DLABDE/-/src/RTOS电_mpu/readme.txt

工程文件说明：

freeRTOS，移植的实时操作系统

Libraries，移植的STM32F4官方库文件

Output，工程输出文件

Project，工程目录

User，用户代码
	eMPL，移植的MPU6050陀螺仪官方解算代码

keilkill.bat，windows脚本文件，自动清除工程编译产生的中间文件
