DLABDE/-/img/3-2.png

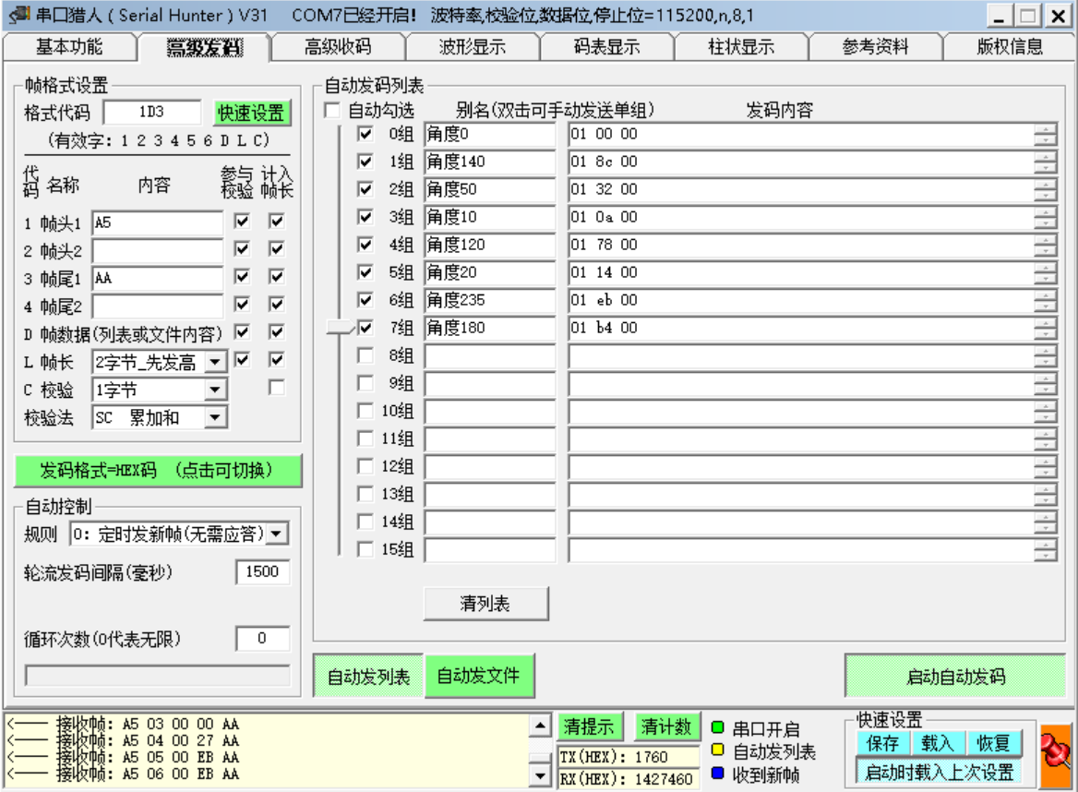
img/3-2.png
