DLABDE/-/img/3-4.png

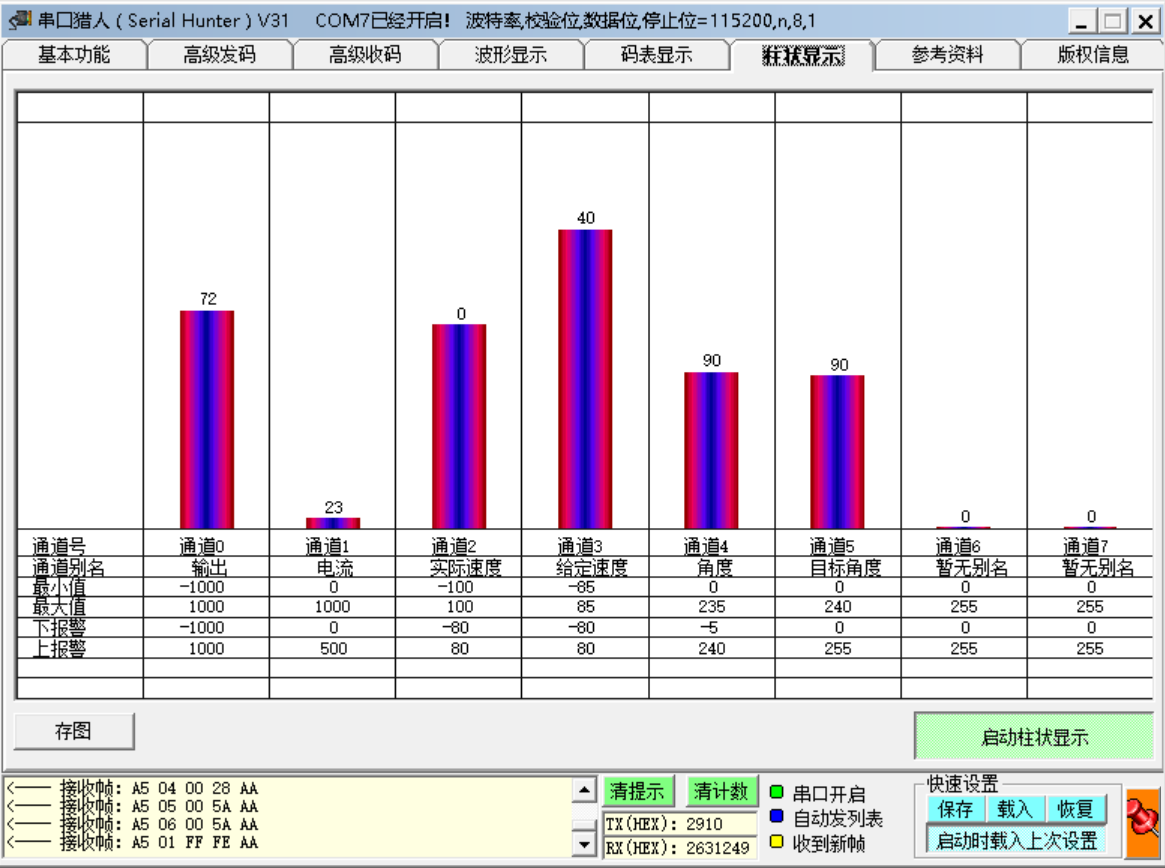
img/3-4.png
