DLABDE/-/img/xiaoming.jpg

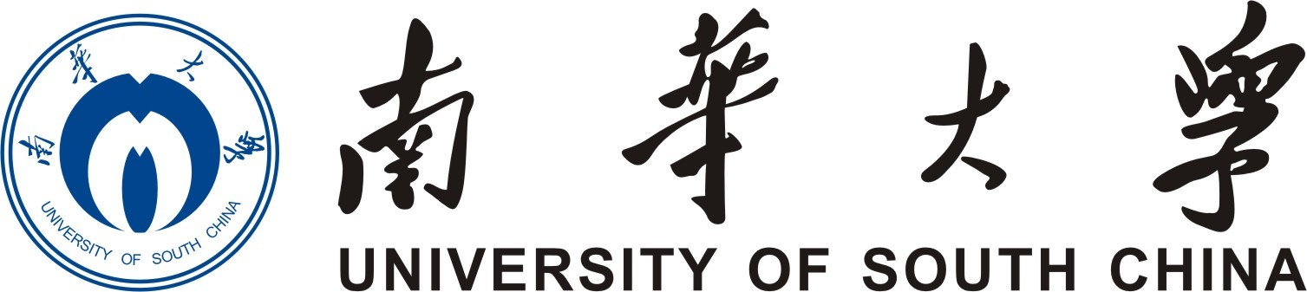
img/xiaoming.jpg
