DLABDE/-/img/控制板.jpg

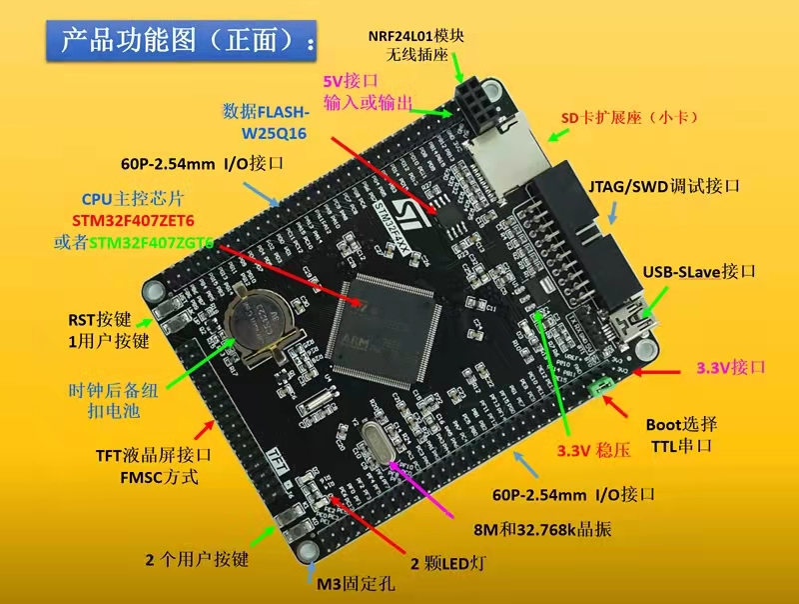
img/控制板.jpg
