DLABDE/-/img/空载角度.png

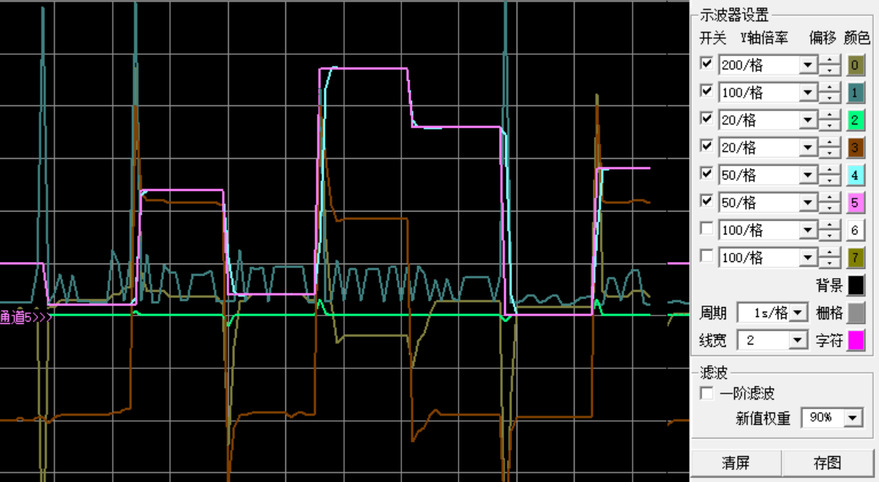
img/空载角度.png
