DLABDE/-/img/随动.png

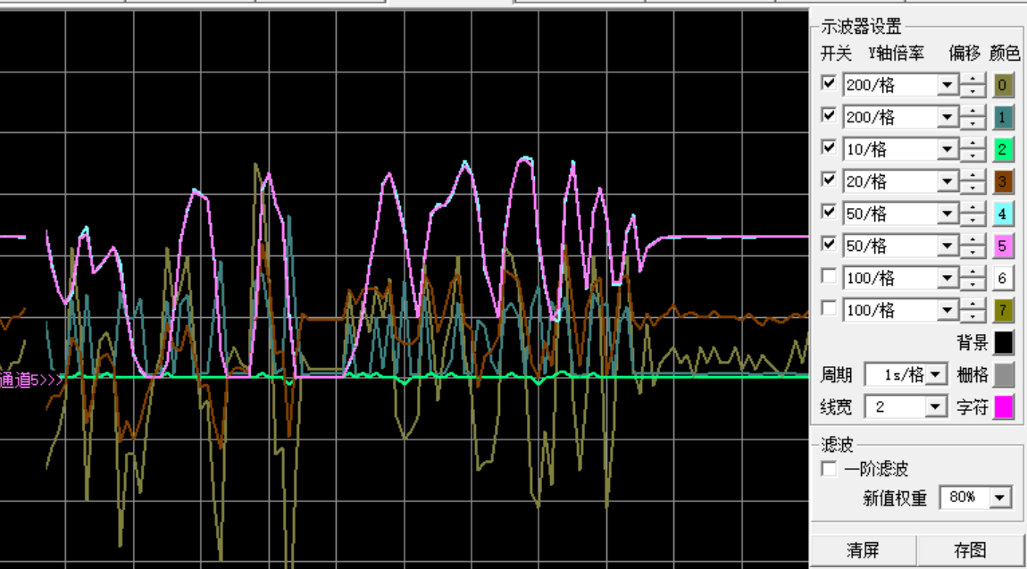
img/随动.png
