DLABDE/-/src/RTOS电_mpu/User/bmp.h

#ifndef __BMP_H
#define __BMP_H

/*BMP图片数据*/

unsigned char BMP[] =
{
0x00,0x00,0x00,0x00,0x00,0x00,0x00,0x00,0x00,0x00,0x00,0xF0,0xF0,0xE0,0x80,0x00,
0x00,0x00,0x00,0x00,0x00,0x00,0x00,0x00,0x00,0x00,0x00,0x00,0x00,0x00,0x00,0x00,
0x00,0x00,0x00,0x00,0x00,0x00,0x00,0x00,0x00,0x00,0x00,0x00,0x00,0x00,0x00,0x00,
0xF8,0xFC,0xF8,0x00,0xC0,0xF0,0xF8,0x7E,0x78,0x70,0x00,0x00,0x00,0x00,0x00,0x00,
0x00,0x00,0x00,0x00,0x00,0x00,0x00,0x00,0x00,0x00,0x00,0x00,0x00,0x00,0x00,0x00,
0x00,0x00,0x00,0x00,0x00,0x00,0x00,0x00,0x00,0x00,0x00,0x00,0x00,0x00,0x00,0x00,
0x00,0x00,0x00,0x00,0x00,0x00,0x00,0x00,0x00,0x00,0x00,0x00,0x00,0x00,0x00,0x00,
0x00,0x00,0x00,0x00,0x00,0xC0,0xFF,0xFF,0xFE,0x00,0x00,0x00,0x00,0x00,0x00,0x00,
0x00,0x00,0x00,0x00,0x00,0x00,0x00,0x00,0xC0,0xFF,0xFF,0xFF,0x9F,0xC0,0xC0,0xF0,
0x60,0x00,0x00,0x00,0x00,0x00,0x00,0x00,0x00,0x00,0x00,0x00,0x00,0x00,0x00,0x00,
0x00,0x00,0x00,0x00,0x00,0x00,0x00,0x00,0x00,0x00,0x00,0x00,0x1C,0x9E,0xFF,0xFF,
0xEF,0xE7,0xE3,0xFD,0xFE,0xF0,0x78,0x38,0x00,0x00,0x00,0x00,0x00,0x00,0x00,0x00,
0x00,0x00,0x00,0x00,0x00,0x00,0x00,0x00,0x00,0x00,0x00,0x00,0x00,0x00,0x00,0x00,
0x80,0xFE,0xFC,0xE0,0x00,0x00,0x00,0x00,0x00,0x00,0x00,0x00,0x00,0x00,0x00,0x00,
0x00,0x00,0x00,0x00,0x00,0x00,0x00,0x00,0x00,0x00,0x00,0x0E,0x7C,0xF8,0xE0,0xF0,
0xF8,0x7C,0xFF,0xF7,0xF3,0xF1,0x78,0xBC,0xFC,0xFE,0xFE,0x3C,0x00,0x00,0x00,0x00,
0x00,0x78,0xF8,0xFC,0x7C,0x3E,0xFF,0xFF,0x7F,0x87,0xC3,0xC1,0xE0,0x70,0xF8,0xF0,
0x00,0x00,0x00,0x00,0x00,0x00,0x00,0x00,0x00,0x00,0x00,0x00,0x00,0x00,0x00,0x00,
0x00,0x00,0x00,0x00,0x00,0x00,0x00,0x60,0xF0,0xF8,0x7C,0x7F,0x7F,0xFF,0xFF,0xFF,
0xDF,0xE7,0x71,0x38,0x3C,0x1E,0x07,0x00,0x00,0x00,0x00,0x00,0x00,0x00,0x00,0x00,
0x00,0x00,0x00,0x00,0x00,0x00,0x00,0x00,0x00,0x00,0x00,0x00,0x00,0x00,0xFF,0xFF,
0xFF,0xF0,0xFE,0x3C,0x18,0x00,0x00,0x00,0x00,0x00,0x00,0x00,0x00,0x00,0x00,0x00,
0x00,0x00,0x00,0x00,0x00,0x00,0x00,0x00,0x00,0x7F,0xFE,0xFB,0xFF,0xFF,0xFE,0x7F,
0x5F,0xFF,0xFF,0xFF,0xFE,0xFF,0x9F,0x07,0x01,0x00,0x00,0x00,0x80,0x80,0x00,0xC0,
0xE0,0xF0,0xF8,0xFC,0xFF,0x1F,0xFF,0x7B,0x71,0x00,0x00,0xFE,0xFF,0x01,0x00,0x00,
0x00,0x00,0x00,0x00,0x00,0x00,0x00,0x00,0x00,0x00,0x00,0x00,0x00,0x00,0x00,0x00,
0x00,0x00,0x80,0xC0,0xE0,0xF0,0x78,0x1C,0x0E,0x06,0x03,0xFF,0xFF,0xFF,0xE0,0xC0,
0x00,0x00,0x00,0x00,0x00,0x00,0x00,0x00,0x00,0x00,0x00,0x00,0x00,0x00,0x00,0x00,
0x00,0x00,0x00,0x00,0x00,0x00,0x00,0x06,0x0E,0x0E,0x8F,0xFF,0xFF,0x3F,0x03,0x01,
0x00,0x00,0x00,0x00,0x00,0x00,0x00,0x00,0x00,0x00,0x00,0x00,0x00,0x00,0x00,0x00,
0x00,0x00,0x00,0x00,0x00,0x00,0x00,0x00,0x7B,0x7B,0x7D,0x3C,0x3E,0x9E,0xFF,0xFF,
0x7F,0x3F,0x1F,0x0F,0x03,0x00,0x00,0x00,0x00,0x00,0x8F,0xFF,0xFF,0xFD,0x03,0x03,
0x31,0xBB,0xFF,0xFF,0xEF,0x02,0x00,0x00,0xFE,0xFF,0xFF,0x00,0x00,0x00,0x00,0x00,
0x00,0x00,0x00,0x00,0x00,0x00,0x00,0x00,0x00,0x00,0x00,0x00,0x00,0x00,0x07,0x0F,
0x1F,0x0F,0x07,0x00,0x00,0x78,0x7C,0x7E,0x3F,0xFF,0xFF,0xFF,0x03,0x01,0x00,0x00,
0x00,0x00,0x00,0x00,0x00,0x00,0x00,0x00,0x00,0x00,0x00,0x00,0x00,0x00,0x00,0x00,
0x00,0x00,0x00,0x00,0x40,0xF0,0xF8,0x7E,0x1F,0x07,0x0D,0x1C,0x3C,0xF8,0xF0,0xE0,
0x00,0x00,0x00,0x00,0x00,0x00,0x00,0x00,0x00,0x00,0x00,0x00,0x00,0x00,0x00,0x00,
0x00,0x00,0x80,0xC0,0xE0,0xF0,0xF8,0xF8,0xFC,0x7C,0xBE,0xFF,0xFF,0x7E,0x7F,0x3F,
0x1F,0x0E,0x00,0x00,0x00,0x00,0x00,0x00,0x3F,0x7F,0x7F,0x1F,0x00,0x00,0x03,0x1F,
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
};


#endif /*__BMP_H*/
