DLABDE/-/src/RTOS电_mpu/User/pwm.c

#include "app.h"


static void pwm_gpio_init()
{
	RCC_AHB1PeriphClockCmd(RCC_AHB1Periph_GPIOA, ENABLE);
	
	GPIO_InitTypeDef GPIO_InitStructure;
	GPIO_InitStructure.GPIO_Pin = GPIO_Pin_5;       //控制正负转
	GPIO_InitStructure.GPIO_Mode = GPIO_Mode_OUT;     
	GPIO_InitStructure.GPIO_Speed = GPIO_Speed_2MHz;	
	GPIO_InitStructure.GPIO_OType = GPIO_OType_PP;    
	GPIO_InitStructure.GPIO_PuPd = GPIO_PuPd_DOWN;  
	GPIO_Init(GPIOA,&GPIO_InitStructure);            
	
	GPIO_PinAFConfig(GPIOA,GPIO_PinSource7,GPIO_AF_TIM14); //GPIOA7复用为定时器14
	GPIO_InitStructure.GPIO_Pin = GPIO_Pin_7;        			//PWM输出
	GPIO_InitStructure.GPIO_Mode = GPIO_Mode_AF;        //复用功能
	GPIO_InitStructure.GPIO_Speed = GPIO_Speed_100MHz;
	GPIO_InitStructure.GPIO_OType = GPIO_OType_PP;      //推挽复用输出
	GPIO_InitStructure.GPIO_PuPd = GPIO_PuPd_DOWN;     
	GPIO_Init(GPIOA,&GPIO_InitStructure);             
}

static void TIM14_PWM_Init()
{		 					 	
	TIM_TimeBaseInitTypeDef  TIM_TimeBaseStructure;
	TIM_OCInitTypeDef  TIM_OCInitStructure;
	RCC_APB1PeriphClockCmd(RCC_APB1Periph_TIM14,ENABLE);  
	
	TIM_TimeBaseStructure.TIM_Prescaler=PSC_PWM;  //定时器分频
	TIM_TimeBaseStructure.TIM_CounterMode=TIM_CounterMode_Up; //向上计数模式
	TIM_TimeBaseStructure.TIM_Period=ARR_PWM;   //自动重装载值
	TIM_TimeBaseStructure.TIM_ClockDivision=TIM_CKD_DIV1; 
	
	TIM_TimeBaseInit(TIM14,&TIM_TimeBaseStructure);//初始化定时器14
	
	//初始化TIM14 Channel1 PWM模式	 
	TIM_OCInitStructure.TIM_OCMode = TIM_OCMode_PWM1; //选择定时器模式:TIM脉冲宽度调制模式2
 	TIM_OCInitStructure.TIM_OutputState = TIM_OutputState_Enable; //比较输出使能
	TIM_OCInitStructure.TIM_OCPolarity = TIM_OCPolarity_High; //输出极性:TIM输出比较极性高
	TIM_OC1Init(TIM14, &TIM_OCInitStructure);  //根据T指定的参数初始化外设TIM1 4OC1

	TIM_OC1PreloadConfig(TIM14, TIM_OCPreload_Enable);  //使能TIM14在CCR1上的预装载寄存器
 
  TIM_ARRPreloadConfig(TIM14,ENABLE);//ARPE使能 
	
	TIM_Cmd(TIM14, ENABLE);  //使能TIM14
}  

void set_pwm(int16_t mot_pwm)
{
	if(mot_pwm>=0)//正转
	{
		GPIO_SetBits(GPIOA,GPIO_Pin_5);
		TIM_SetCompare1(TIM14,mot_pwm);
	}
	else	//反转
	{
		GPIO_ResetBits(GPIOA,GPIO_Pin_5);
		TIM_SetCompare1(TIM14,(-mot_pwm));
	}
}

void PWM_Init()
{
	pwm_gpio_init();
	TIM14_PWM_Init();
}
