DLABDE/-/src/RTOS电_mpu/User/generaltim.h

#ifndef _GENERALTIM_H_
#define _GENERALTIM_H_

#include "stm32f4xx.h"

#define GENERAL_TIM           		TIM5
#define GENERAL_TIM_CLK       		RCC_APB1Periph_TIM5

#define GENERAL_TIM_IRQn					TIM5_IRQn
#define GENERAL_TIM_IRQHandler    TIM5_IRQHandler


void TIMx_Configuration(void);

#endif /*_GENERALTIM_H_*/
