DLABDE/-/(commit log)

2022-06-05 新建工程
2022-11-02 改善IIC_更新README
