DLABDE/-/(notices)

Notices in the files:
src/RTOS电_mpu/User/eMPL/inv_mpu.c:
Copyright(C) ¹ãÖÝÊÐÐÇÒíµç×Ó¿Æ¼¼ÓÐÏÞ¹«Ë¾ 2014-2024
All rights reserved
